iuripinto/Controlo-de-voo-e-telemetria-de-um-Drone/Estrutura/EstruturaParaZipar/PerformanceLog.txt

Number of Contacts: 55
Number of contact data: 13247
