iuripinto/Controlo-de-voo-e-telemetria-de-um-Drone/Estrutura/EstruturaParaZipar/S5020.jpg

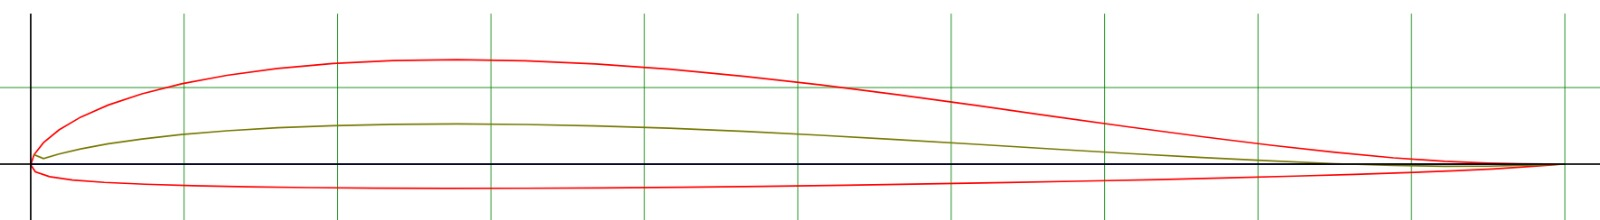
Estrutura/EstruturaParaZipar/S5020.jpg
