iuripinto/Controlo-de-voo-e-telemetria-de-um-Drone/Estrutura/EstruturaParaZipar/Assem_Asa.SLDASM

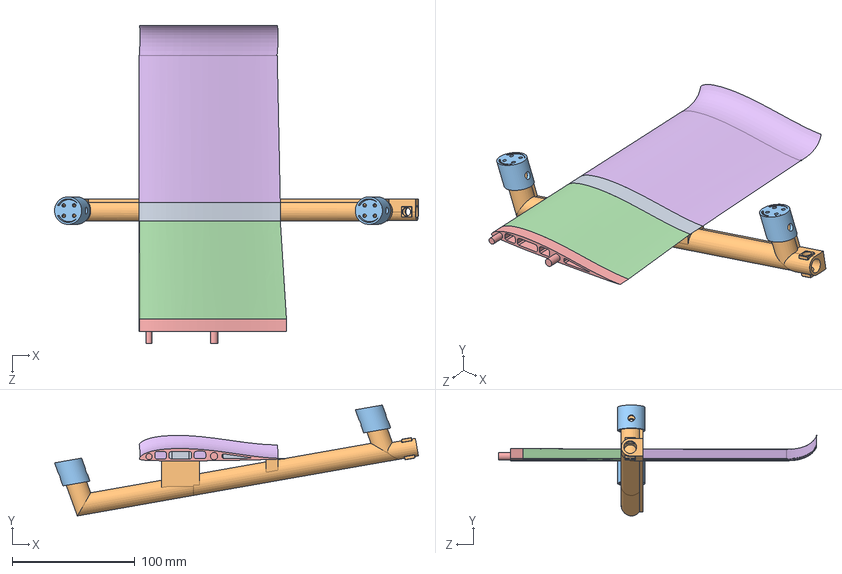
[picture p29: CAD file, 2025-06-23]
Estrutura/EstruturaParaZipar/Assem_Asa.SLDASM
296.7 x 90.4 x 259.6 mm
Estrutura_Asa_L
Estrutura_Sup_asa_4
Estrutura_asa_3
Sup_Motores x 2
Estrutura_Sup_asa_2_2
Tubo
