iuripinto/Controlo-de-voo-e-telemetria-de-um-Drone/Estrutura/EstruturaParaZipar/Estrutura_asa_1.SLDPRT

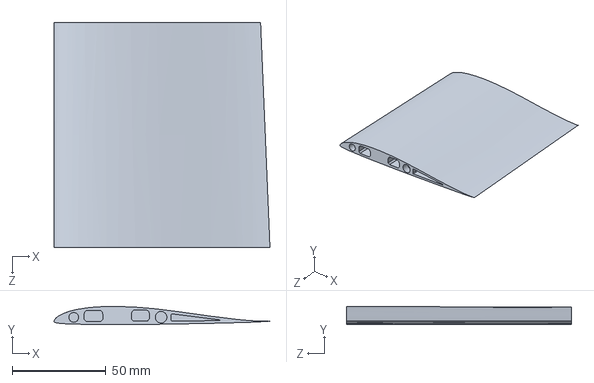
[picture p30: CAD file, 2025-06-23]
Estrutura/EstruturaParaZipar/Estrutura_asa_1.SLDPRT
115.0 x 9.64 x 120.0 mm
