iuripinto/Controlo-de-voo-e-telemetria-de-um-Drone/Estrutura/EstruturaParaZipar/Estrutura_Corpo_Topo_7.SLDPRT

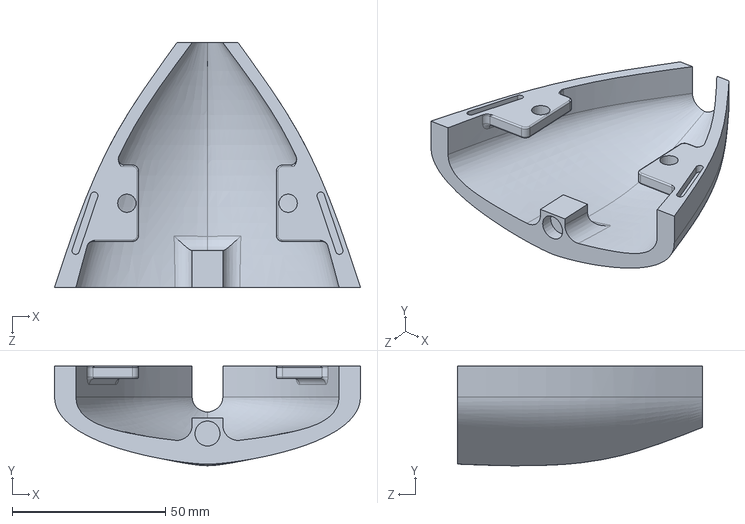
[picture p32: CAD file, 2025-06-23]
Estrutura/EstruturaParaZipar/Estrutura_Corpo_Topo_7.SLDPRT
100.0 x 32.5 x 80.0 mm
