iuripinto/Controlo-de-voo-e-telemetria-de-um-Drone/Estrutura/EstruturaParaZipar/Estrutura_Corpo_Topo_5.SLDPRT

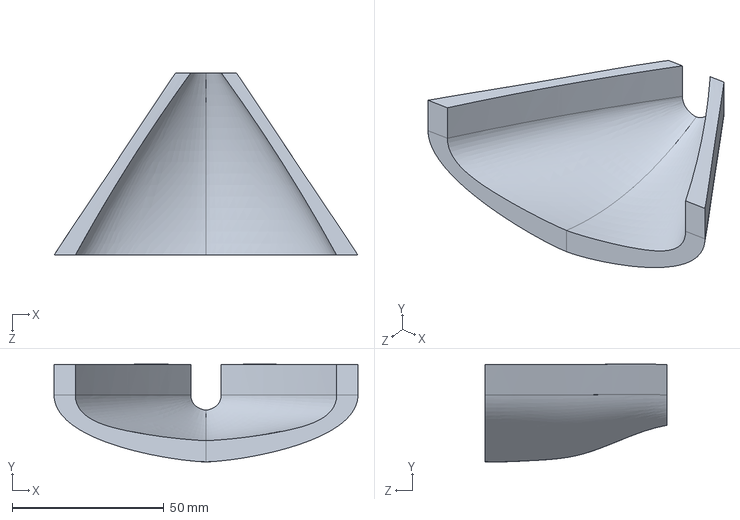
[picture p33: CAD file, 2025-06-23]
Estrutura/EstruturaParaZipar/Estrutura_Corpo_Topo_5.SLDPRT
100.0 x 32.2 x 60.0 mm
