iuripinto/Controlo-de-voo-e-telemetria-de-um-Drone/Estrutura/EstruturaParaZipar/Estrutura_Corpo_Base_5.SLDPRT

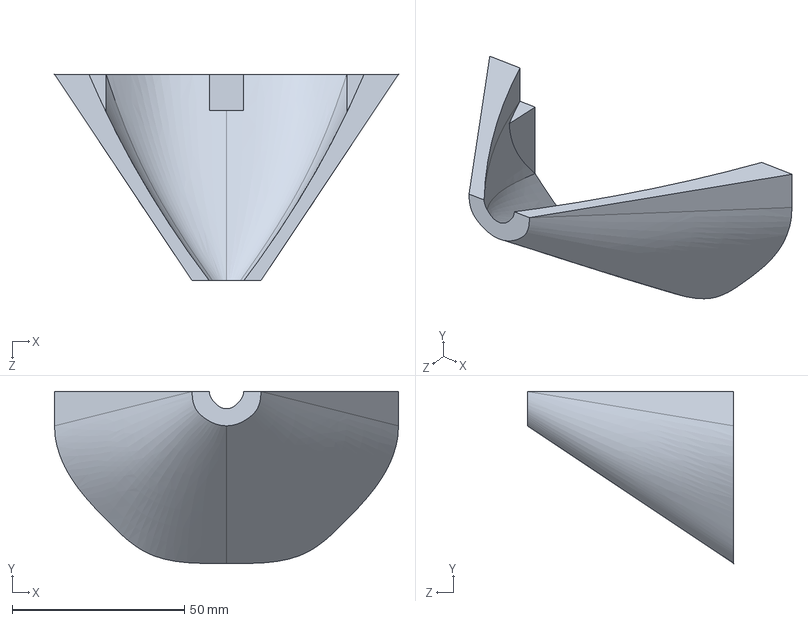
[picture p35: CAD file, 2025-06-23]
Estrutura/EstruturaParaZipar/Estrutura_Corpo_Base_5.SLDPRT
100.0 x 50.0 x 60.0 mm
