iuripinto/Controlo-de-voo-e-telemetria-de-um-Drone/Estrutura/EstruturaParaZipar/Estrutura_asa_3.SLDPRT

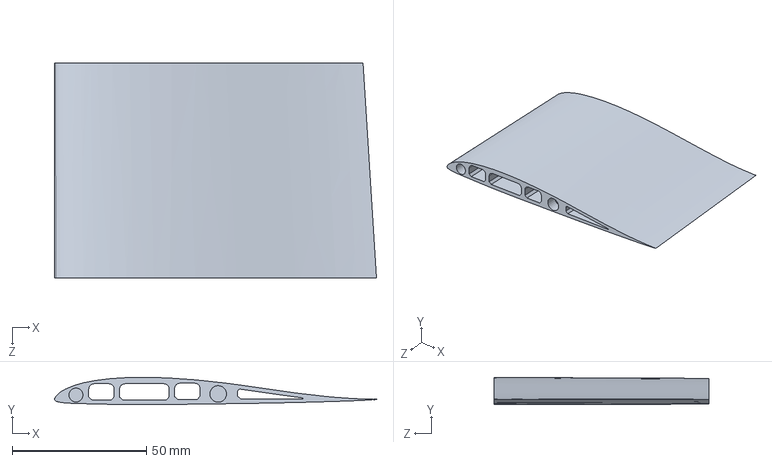
[picture p36: CAD file, 2025-06-23]
Estrutura/EstruturaParaZipar/Estrutura_asa_3.SLDPRT
120.0 x 10.2 x 80.0 mm
