iuripinto/Controlo-de-voo-e-telemetria-de-um-Drone/Estrutura/EstruturaParaZipar/Estrutura_asa_1_2.SLDPRT

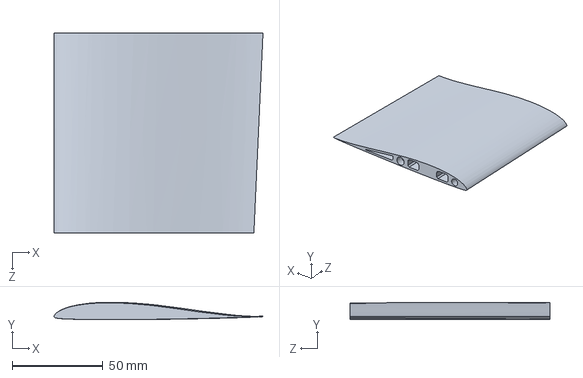
[picture p37: CAD file, 2025-06-23]
Estrutura/EstruturaParaZipar/Estrutura_asa_1_2.SLDPRT
115.0 x 9.63 x 110.0 mm
