iuripinto/Controlo-de-voo-e-telemetria-de-um-Drone/Estrutura/EstruturaParaZipar/Tubo.SLDPRT

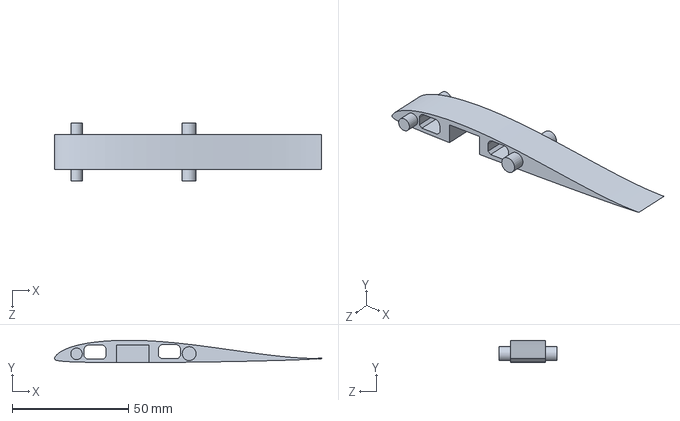
[picture p38: CAD file, 2025-06-23]
Estrutura/EstruturaParaZipar/Tubo.SLDPRT
115.0 x 9.65 x 25.0 mm
