iuripinto/Controlo-de-voo-e-telemetria-de-um-Drone/Estrutura/EstruturaParaZipar/Estrutura_Sup_asa_4.SLDPRT

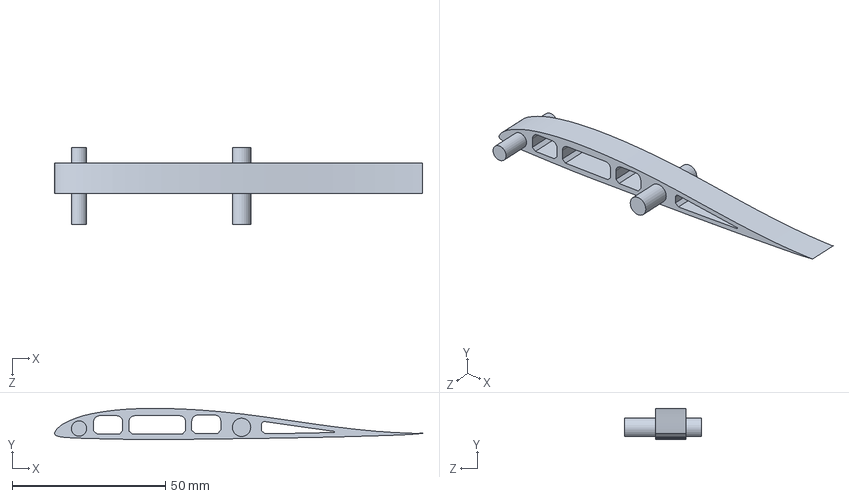
[picture p39: CAD file, 2025-06-23]
Estrutura/EstruturaParaZipar/Estrutura_Sup_asa_4.SLDPRT
120.0 x 10.2 x 25.0 mm
