iuripinto/Controlo-de-voo-e-telemetria-de-um-Drone/Estrutura/EstruturaParaZipar/Pata.SLDPRT

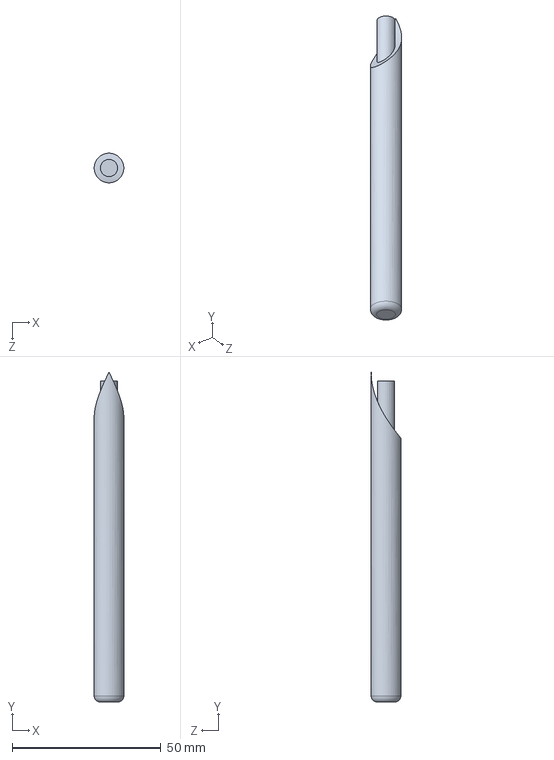
[picture p41: CAD file, 2025-06-23]
Estrutura/EstruturaParaZipar/Pata.SLDPRT
10.00 x 111.1 x 10.0 mm
