iuripinto/Controlo-de-voo-e-telemetria-de-um-Drone/Estrutura/EstruturaParaZipar/Estrutura_Asa_L.SLDPRT

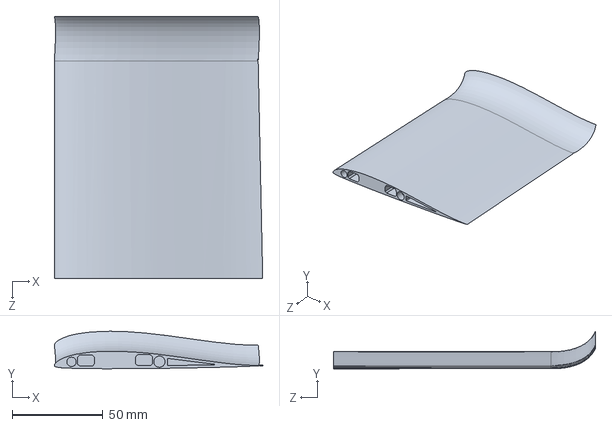
[picture p42: CAD file, 2025-06-23]
Estrutura/EstruturaParaZipar/Estrutura_Asa_L.SLDPRT
115.0 x 20.7 x 144.6 mm
