iuripinto/Controlo-de-voo-e-telemetria-de-um-Drone/Estrutura/EstruturaParaZipar/Estrutura_Barras.SLDPRT

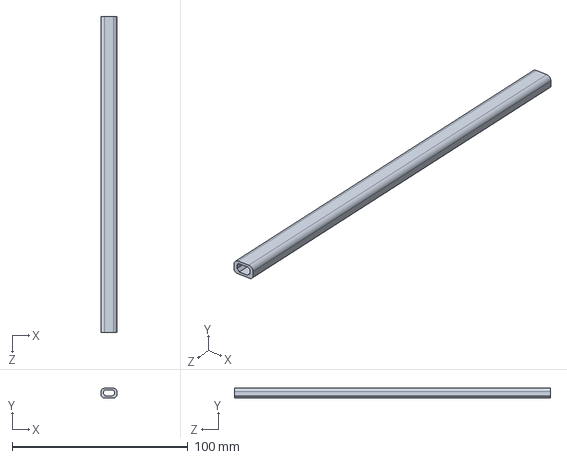
[picture p43: CAD file, 2025-06-23]
Estrutura/EstruturaParaZipar/Estrutura_Barras.SLDPRT
9.00 x 5.50 x 180.0 mm
