iuripinto/Controlo-de-voo-e-telemetria-de-um-Drone/Estrutura/EstruturaParaZipar/Nariz_Frente.SLDPRT

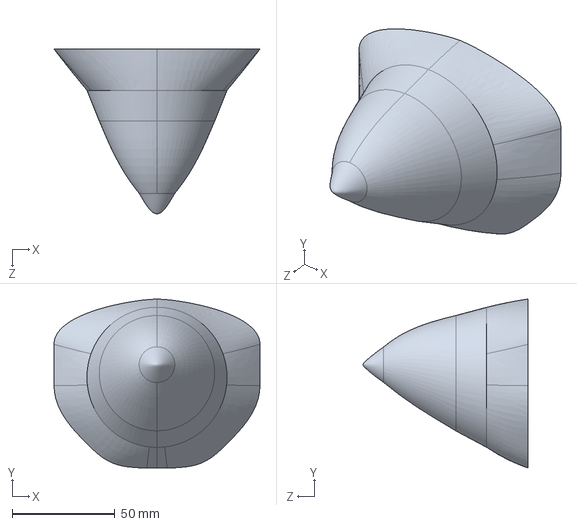
[picture p44: CAD file, 2025-06-23]
Estrutura/EstruturaParaZipar/Nariz_Frente.SLDPRT
100.0 x 82.0 x 80.0 mm
