iuripinto/Controlo-de-voo-e-telemetria-de-um-Drone/Estrutura/EstruturaParaZipar/Estrutura_Corpo_Base_6.SLDPRT

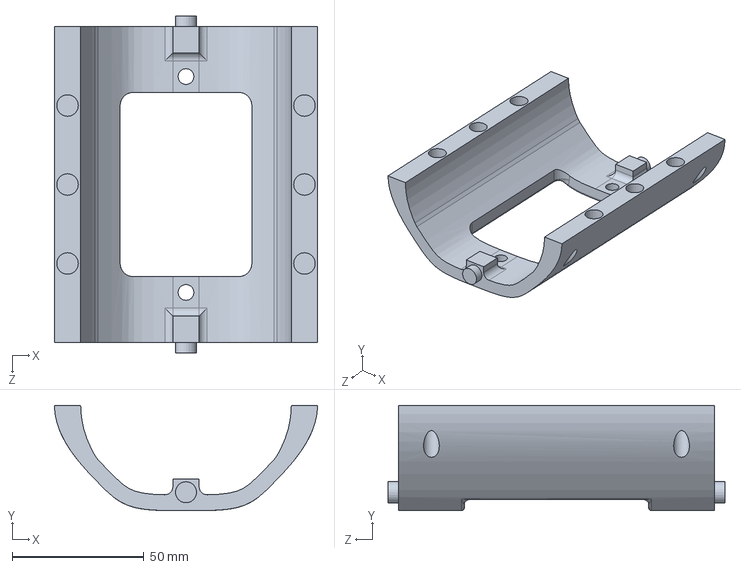
[picture p45: CAD file, 2025-06-23]
Estrutura/EstruturaParaZipar/Estrutura_Corpo_Base_6.SLDPRT
100.0 x 40.0 x 128.0 mm
