iuripinto/Controlo-de-voo-e-telemetria-de-um-Drone/Estrutura/EstruturaParaZipar/Sup_Motores.SLDPRT

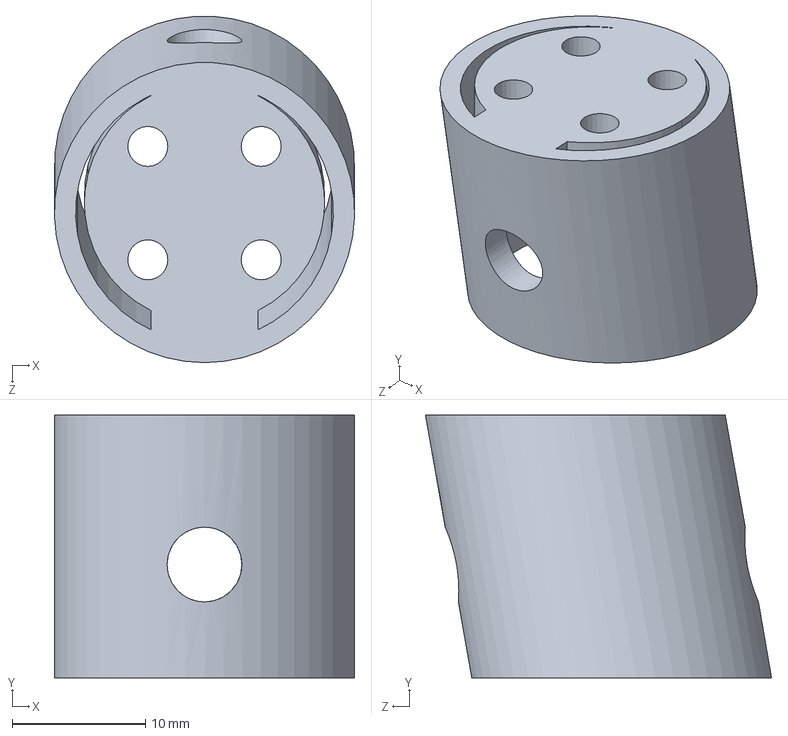
[picture p46: CAD file, 2025-06-23]
Estrutura/EstruturaParaZipar/Sup_Motores.SLDPRT
22.5 x 19.7 x 25.9 mm
