iuripinto/Controlo-de-voo-e-telemetria-de-um-Drone/Estrutura/EstruturaParaZipar/Estrututa_Corpo_6.SLDPRT

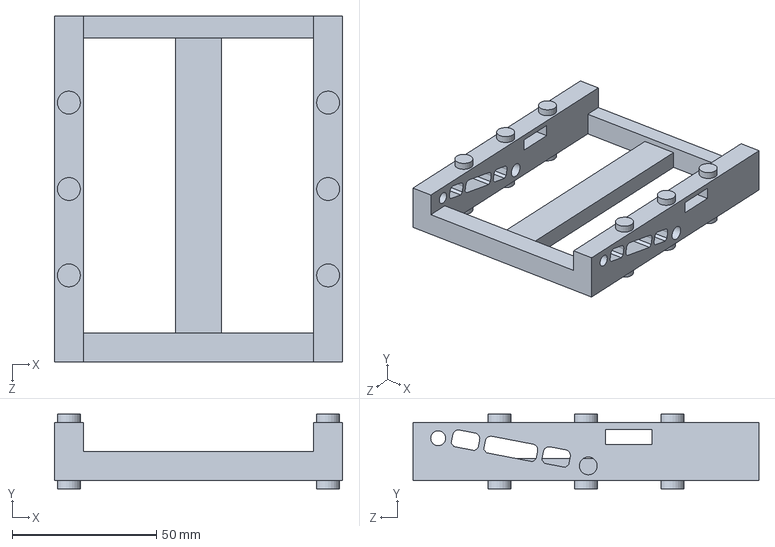
[picture p47: CAD file, 2025-06-23]
Estrutura/EstruturaParaZipar/Estrututa_Corpo_6.SLDPRT
100.0 x 26.0 x 120.0 mm
