iuripinto/Controlo-de-voo-e-telemetria-de-um-Drone/Estrutura/EstruturaParaZipar/MirrorEcaixe_Cauda_Sup.SLDPRT

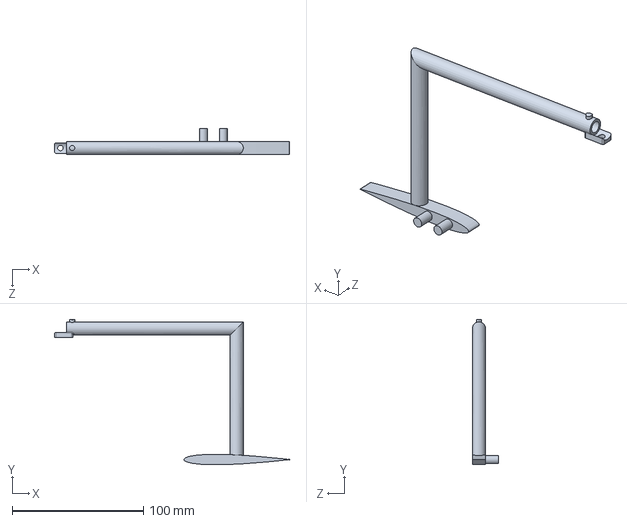
[picture p48: CAD file, 2025-06-23]
Estrutura/EstruturaParaZipar/MirrorEcaixe_Cauda_Sup.SLDPRT
179.2 x 111.0 x 20.0 mm
