iuripinto/Controlo-de-voo-e-telemetria-de-um-Drone/Estrutura/EstruturaParaZipar/Estrutura_Sup_asa_2_2.SLDPRT

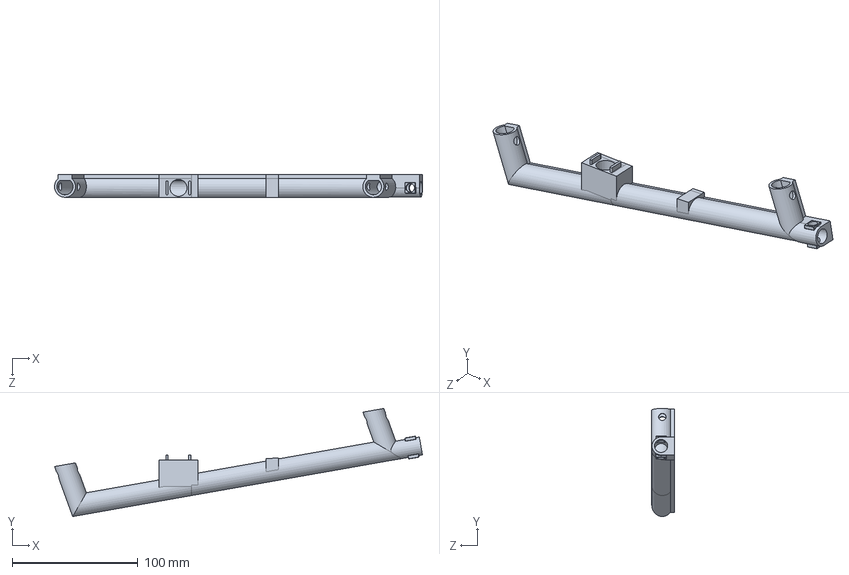
[picture p49: CAD file, 2025-06-23]
Estrutura/EstruturaParaZipar/Estrutura_Sup_asa_2_2.SLDPRT
292.5 x 85.9 x 18.0 mm
