iuripinto/Controlo-de-voo-e-telemetria-de-um-Drone/Estrutura/EstruturaParaZipar/Assem_Corpo.SLDASM

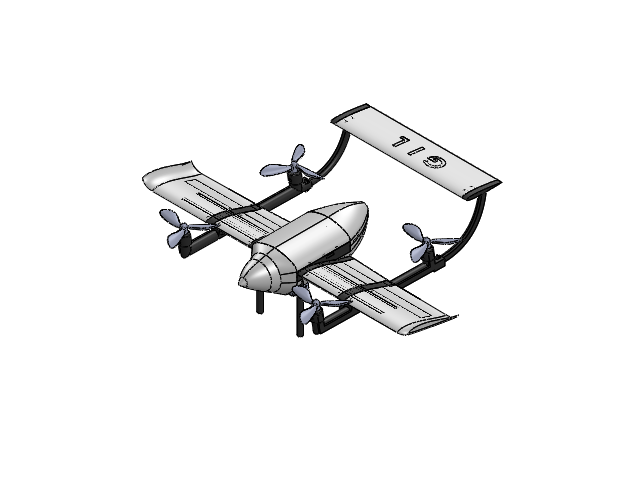
[picture p50: CAD file, 2025-06-23]
Estrutura/EstruturaParaZipar/Assem_Corpo.SLDASM
Estrututa_Corpo_6
Estrutura_Corpo_Base_6
Estrutura_Asa_L
Estrutura_Sup_asa_4
Estrutura_asa_3
Sup_Motores x 4
Helice x 4
Estrutura_Sup_asa_2_2
Tubo
MirrorEstrutura_Asa_L
MirrorEstrutura_asa_3
MirrorEstrutura_Sup_asa_2_2
MirrorTubo
MirrorEstrutura_Sup_asa_4
Estrutura_Corpo_Base_7
Estrutura_Barras x 4
Estrutura_Corpo_Topo_6
Estrutura_Corpo_Topo_7
Nariz_Frente
Cauda
Ecaixe_Cauda_Sup
Pata x 4
Barra_Sup_Sensores
ESP32
A9G
BarraCamTerm
BarraCO2
Cam Termica
CO2
Sup CamTerm
SupCO2
MirrorEcaixe_Cauda_Sup
