iuripinto/Controlo-de-voo-e-telemetria-de-um-Drone/(list of files, cad)

Other CAD files:
Estrutura/EstruturaParaZipar/MirrorAssTubos.SLDASM
Estrutura/EstruturaParaZipar/MirrorEstrutura_asa_3_2.SLDPRT
Estrutura/EstruturaParaZipar/MirrorEstrutura_Sup_asa_2.SLDPRT
Estrutura/EstruturaParaZipar/MirrorSup_Motores.SLDPRT
Estrutura/EstruturaParaZipar/MirrorEstrutura_Sup_asa_2_2.SLDPRT
Estrutura/EstruturaParaZipar/Estrutura_asa_3_2.SLDPRT
Estrutura/EstruturaParaZipar/MirrorTubo.SLDPRT
Estrutura/EstruturaParaZipar/MirrorEstrutura_asa_3.SLDPRT
Estrutura/EstruturaParaZipar/MirrorEstrutura_Asa_L.SLDPRT
Estrutura/EstruturaParaZipar/MirrorEstrutura_Sup_asa_4.SLDPRT
